hominhthao/rms-anomaly-detection-ip/img/waveform_shift_avg.png

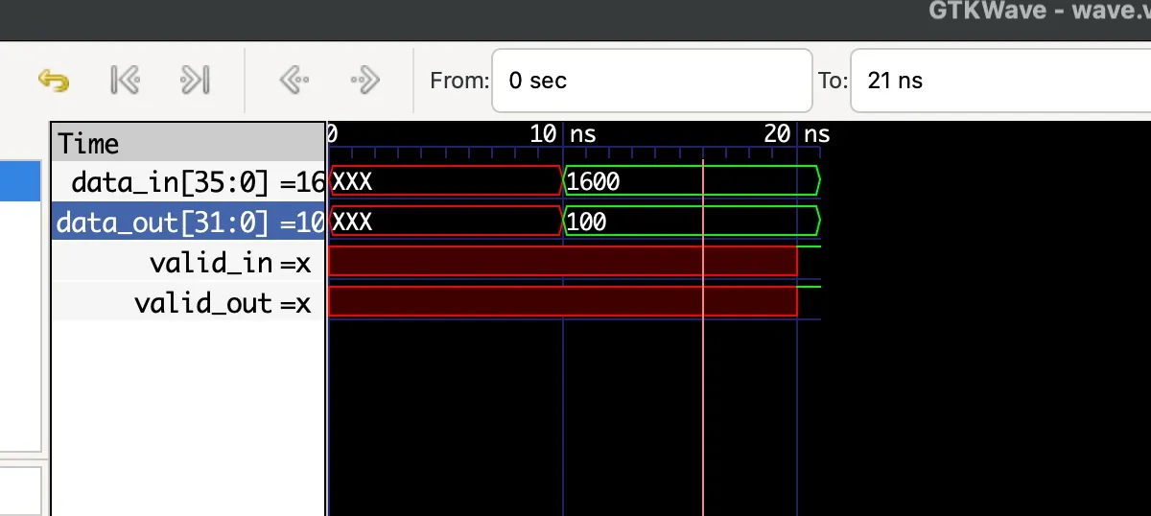
img/waveform_shift_avg.png
