hominhthao/rms-anomaly-detection-ip/(commit log)

2026-03-17 feat: add squaring_unit and accumulator RTL with testbenches
    - squaring_unit: 16-bit signed input, 32-bit output, combinational
    - accumulator: 16-sample window, 36-bit sum, valid_out handshake
    - both modules verified via directed testbench on Icarus Verilog
2026-03-18 feat: add shift_avg, comparator, rms_top — full pipeline complete
2026-03-18 feat: complete pipeline — shift_avg, comparator, rms_top, full README
2026-03-18 feat: add synthesis results — Gowin GW1N-1, Fmax 120MHz
2026-03-18 docs: add synthesis schematic screenshots
2026-03-19 test: replace synthetic inputs with physically-derived vectors (0.3g normal, 1.5g bearing fault @ 120Hz, ±16g sensor)
    [tb_rms_top.v]
2026-03-19 fix: update THRESHOLD to 1_200_000 — calibrated from physical model (3x normal RMS2, ±16g sensor)
    [comparator.v]
2026-03-19 docs: full README rewrite — automotive positioning, engineering depth, physical test methodology
2026-03-19 docs: restore synthesis screenshots — resource, timing, RTL schematics
2026-03-19 docs: final polish — sharper opening, waveform explanations, physical context
2026-04-04 docs: add power analysis, hardware validation, demo wrapper
    - Power: 0.38mW dynamic, 7.32mW total (Gowin Power Analyzer)
    - Hardware: LED verified on Tang Nano 1K silicon
    - Add demo/tang_nano_1k/ wrapper (demo_top.v, uart_tx.v, cst)
    - Add synthesis/waveform images
2026-04-04 docs: add power analysis screenshot
