hominhthao/rms-anomaly-detection-ip/(notices)

Notices in the files:
README.md:
License: MIT
